AnGyeonheal/EV_Aerodynamic_Design/최종 보고서/2024_1_포스터_21900416_안견힐.pdf

# Optimal Design for Improving Drag and Cooling Performance of KSAE E-Mobility through CFD Analysis

G. H. An, C. S. LEE

Handong Global University Mechanical Control Engineering

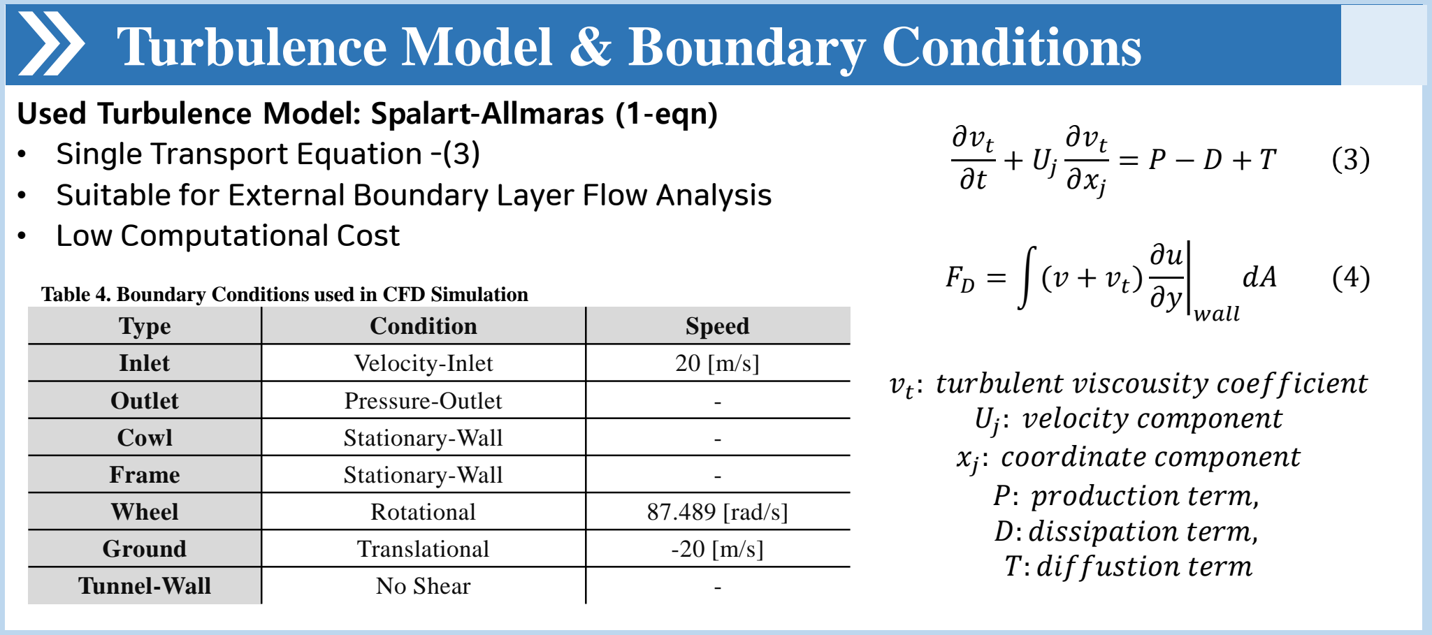
[picture p6: figure]
Turbulence Model & Boundary Conditions; Type; Condition; Speed; Inlet; Velocity-Inlet; Outlet; Pressure-Outlet; Cowl; Stationary-Wall; Frame; Wheel; Rotational; 87.489 [rad/s]; Ground; Translational; Tunnel-Wall; No Shear; Used Turbulence Model: Spalart-Allmaras (1-eqn) • Single Transport Equation -(3); • Low Computational Cost; wall; : turbulent viscousity coefficient Uj; : velocity component; : coordinate component P: production term, D: dissipation term, T: diffustion term

## Introduction

- This project aims to reduce drag and enhance the cooling efficiency of the electronic circuits in an electric vehicle designed for the KSAE (Korea Society of Automotive Engineers) university student competition through CFD (Computational Fluid Dynamics) analysis. The existing vehicle design has a structure that suffers from high drag and ineffective cooling of the electronic circuits. To address these issues, we utilized Ansys Fluent to propose a model that minimizes drag while improving the cooling of the electronic circuits. Additionally, we aim to verify the reliability of the CFD analysis results through wind tunnel experiments. The key factors determining the drag force(FD) of a vehicle are the projected area in the direction of fluid flow(A), the velocity of the fluid v

2
, and the drag coefficient (CD) due to the shape, as shown in Equation (1).
- Therefore, to minimize the flow separation phenomenon (Fig 1), which causes drag, the vehicle was designed with a streamlined shape to reduce the drag coefficient (CD) and to decrease the projected area (A), aiming to minimize the drag force.

## Model Description

- Advanced 1 (Frame Unmodified)
- Advanced 2 (Frame Modified)

Fig 3. NACA 4412 (α = −6°)(XFOIL)

Fig 4. NACA 2412 (α = −3°)(XFOIL)

Fig 5. NACA 4412 (α = −3°)(XFOIL)

- The model was inspired by the Power 0.5 model of Nose Cone Design (1), and the front part of the vehicle was designed with a streamlined shape.

y = R

x
L

2
1

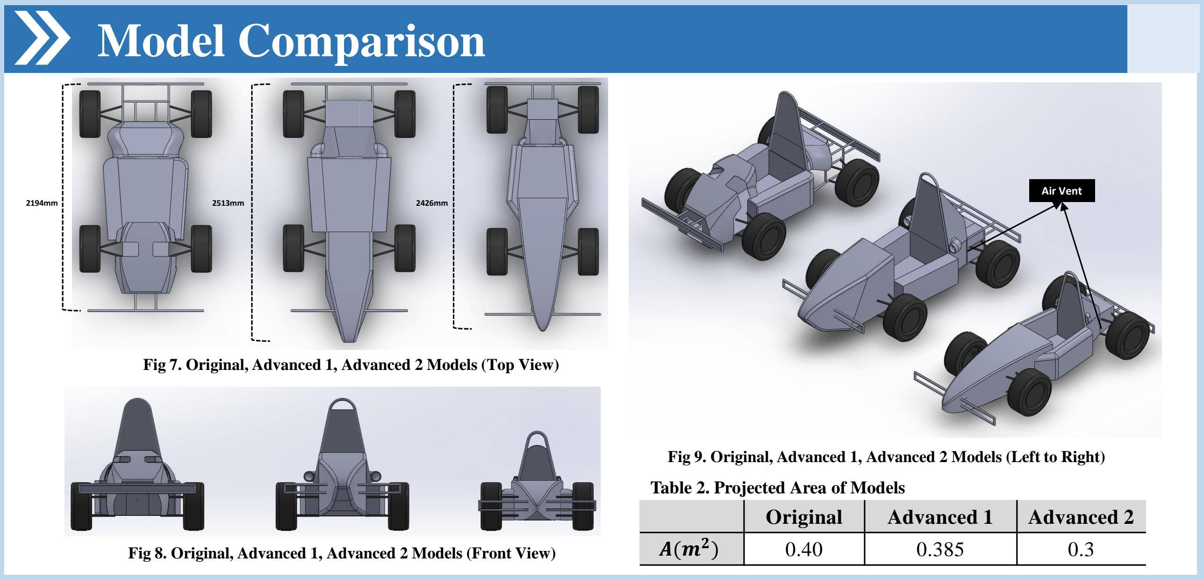
[picture p7: figure]
Fig 5. Original, Advanced 1, Advanced 2 Models (Up view); Model Comparison; Original; Advanced 1; Advanced 2; Air Vent; Table 2. Projected Area of Models

Fig 9. Original, Advanced 1, Advanced 2 Models (Left to Right)

Fig 6. Advanced 2 Model Sketch (NACA 2412)

RRH

NACA 2412

Driver

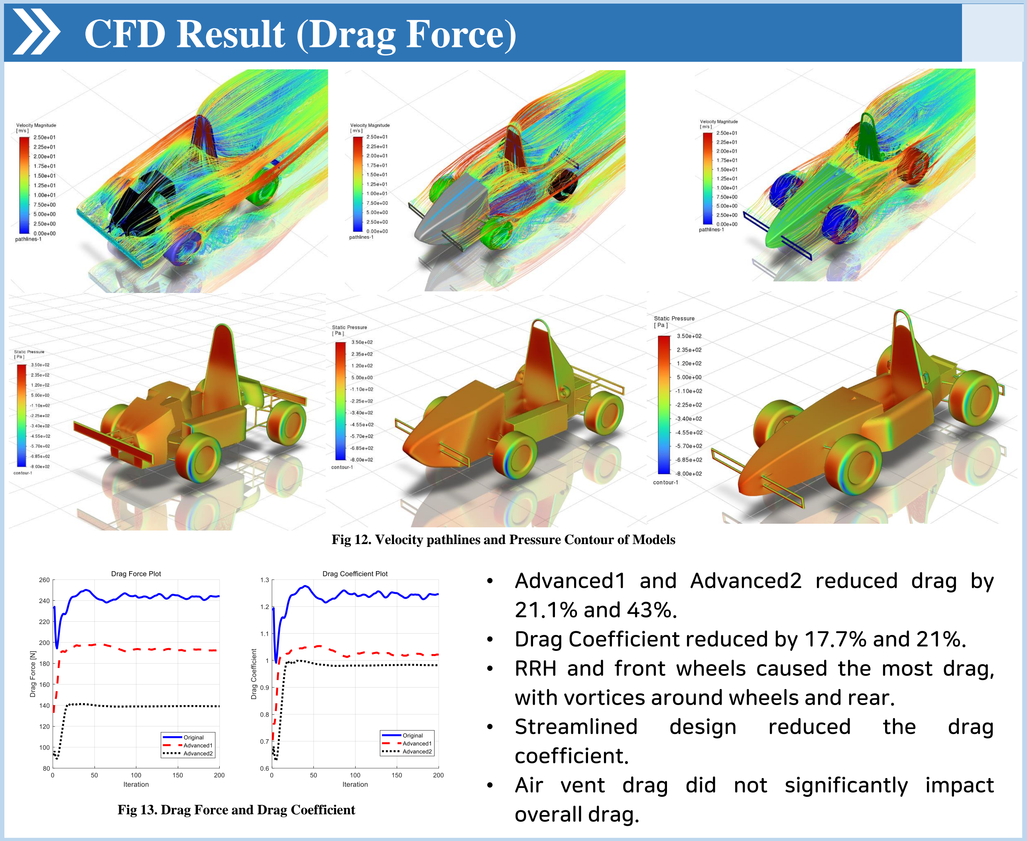
[picture p8: figure]
CFD Result (Drag Force); Fig 13. Drag Force and Drag Coefficient; 21.1% and 43%.; with vortices around wheels and rear.; • Streamlined; design; reduced; the; drag; coefficient.; overall drag.

## CFD Result (Cooling)

## Wind Tunnel Experiment Setting [Further Study]

z

## Discussion & Conclusion

- Suitable for External Boundary Layer Flow Analysis

Table 4. Boundary Conditions used in CFD Simulation

- The design is based on the NACA 2412 airfoil (at AOA, α = −3°), which has a low lift-to-drag ratio, and the smallest drag coefficient CD .
- The driver's seating position was changed from a sitting posture to a 30° reclining posture, reducing the height of the RRH by 350mm.

## Meshing Method

Region | Type | Size (mm)
BOI-nearfield | Body of Influence | 40
BOI-farfield | Body of Influence | 90
Bumper and Rods | Curvature | Min:4 / Max:5
Cowl | Curvature | Min:5 / Max:30
Wheel | Curvature | Min:3.5 / Max: 5
Boundary Layer | Last-ratio | 10 layers / Ratio: 0.2
Surface | Curvature & Proximity | Min: 0.5 / Max: 256
Volume | Poly-hexcore | Min: 0.5 / Max: 512

Table 3. Mesh Conditions

FD =

1
2

ρv

2CDA | 1

Fig 2. Power 0.5 Nose Cone Design

Fig 7. Original, Advanced 1, Advanced 2 Models (Top View)

Fig 8. Original, Advanced 1, Advanced 2 Models (Front View)

Fig 1. Separation Phenomenon

Table 1. Lift-to-Drag Ratio and Drag Coefficient of NACA Airfoil at Different Angles of Attack

Fig 11. Surface Mesh (Left), Volume Mesh (Right)

Fig 10. Mesh Convergence

Power [KW] | 8.6
Torque [Nm] | 33.9
ω [rad/s] | 254.59
Wheel Radius [m] | 0.115
ZA: ZB | 17:50
m [kg] | 250
fl
: friction loss | 0.7
cl
: circuit loss | 0.85

Ftℎrust =

T
R

×

ZB
ZA

× fl × cl = 515.87[N]

Table 5. DIY Car Spec Sheet

Fig 12. Velocity pathlines and Pressure Contour of Models

Fig 14. Rear Cowl Velocity Contour (Original, Advanced 1, Advanced 2)
- By adding an air vent shape, fast-flowing fluid through a narrow passage cools the electronic device with lower temperature fluid. (2.5m/s → 10m/s → 16m/s)

Amplifier

MCU

Rodcell

Honey Comb
Model
Electronic device | Electronic device | Electronic device
- Advanced1 and Advanced2 reduced drag by
- Drag Coefficient reduced by 17.7% and 21%.
- RRH and front wheels caused the most drag,
- Air vent drag did not significantly impact
- Uniform fluid flow is formed after passing through the honeycomb.
- The model's air resistance deforms the rod cell, changing its electrical resistance
- The amplified signal is sent to the MCU to calculate drag.
- The drag coefficient is calculated using the anemometer's fluid velocity and atmospheric conditions, and compared with simulation results

Fig 15. Wind Tunnel Experiment Settings

- The reduced drag (105[N]) is significant compared to the drive force (515.87[N]) from Table 4.
- Reduced drag can improve top speed and acceleration.
- Drag is proportional to the square of speed, so reducing the projected area and drag coefficient reduces drag.
- Safety device (RRH) regulations limited drag coefficient reduction (1.25 → 0.98).
- Adding air vents improved cooling and motor efficiency.
- Running time: 90min. Proper geometry and mesh generation are crucial (16-core process, 2.9 million cells).
