AnGyeonheal/EV_Aerodynamic_Design/최종 보고서/학술대회/생산제조학술대회_포스터_안견힐.pdf

# Optimal Design for Improving Drag and Cooling Performance of KSAE E-Mobility through CFD Analysis

G. H. An, C. S. LEE

Handong Global University Mechanical Control Engineering

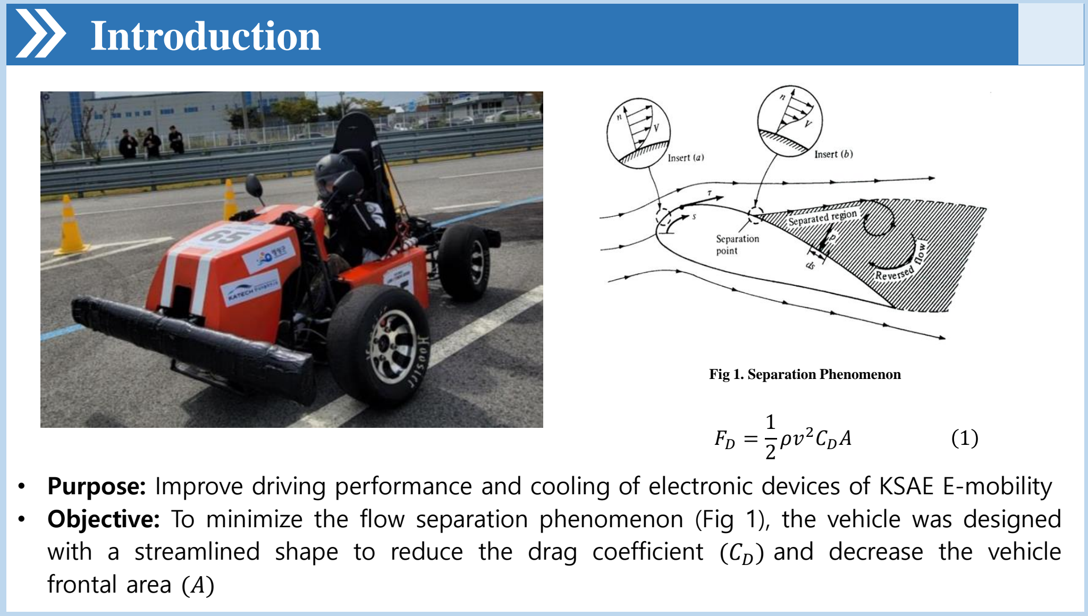
[picture p9: figure]
Introduction; frontal area (A); 2CDA; Fig 1. Separation Phenomenon

- Purpose: Improve driving performance and cooling of electronic devices of KSAE E-mobility
- Objective: To minimize the flow separation phenomenon (Fig 1), the vehicle was designed with a streamlined shape to reduce the drag coefficient (CD) and decrease the vehicle

## Model Description

- Advanced 1 (Frame Unmodified)
- Advanced 2 (Frame Modified)

Fig 3. NACA 4412 (α = −6°)(XFOIL)

Fig 4. NACA 2412 (α = −3°)(XFOIL)

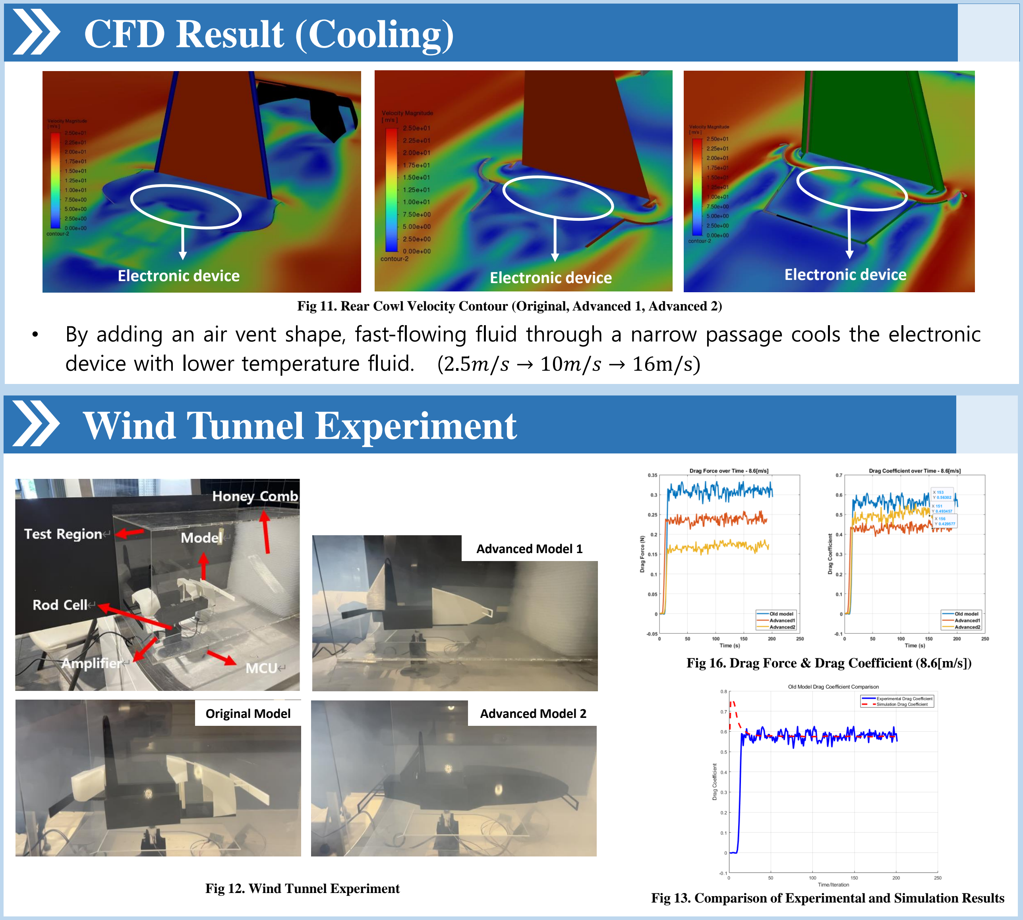
[picture p10: figure]
CFD Result (Cooling); Wind Tunnel Experiment; Electronic device; Fig 12. Wind Tunnel Experiment; Original Model; Advanced Model 1; Advanced Model 2

Fig 5. NACA 4412 (α = −3°)(XFOIL)

- The model was inspired by the Power 0.5 model of Nose Cone Design (1), and the front part of the vehicle was designed with a streamlined shape.

y = R

x
L

2
1

Fig 6. Advanced 2 Model Sketch (NACA 2412)

RRH

NACA 2412

Driver

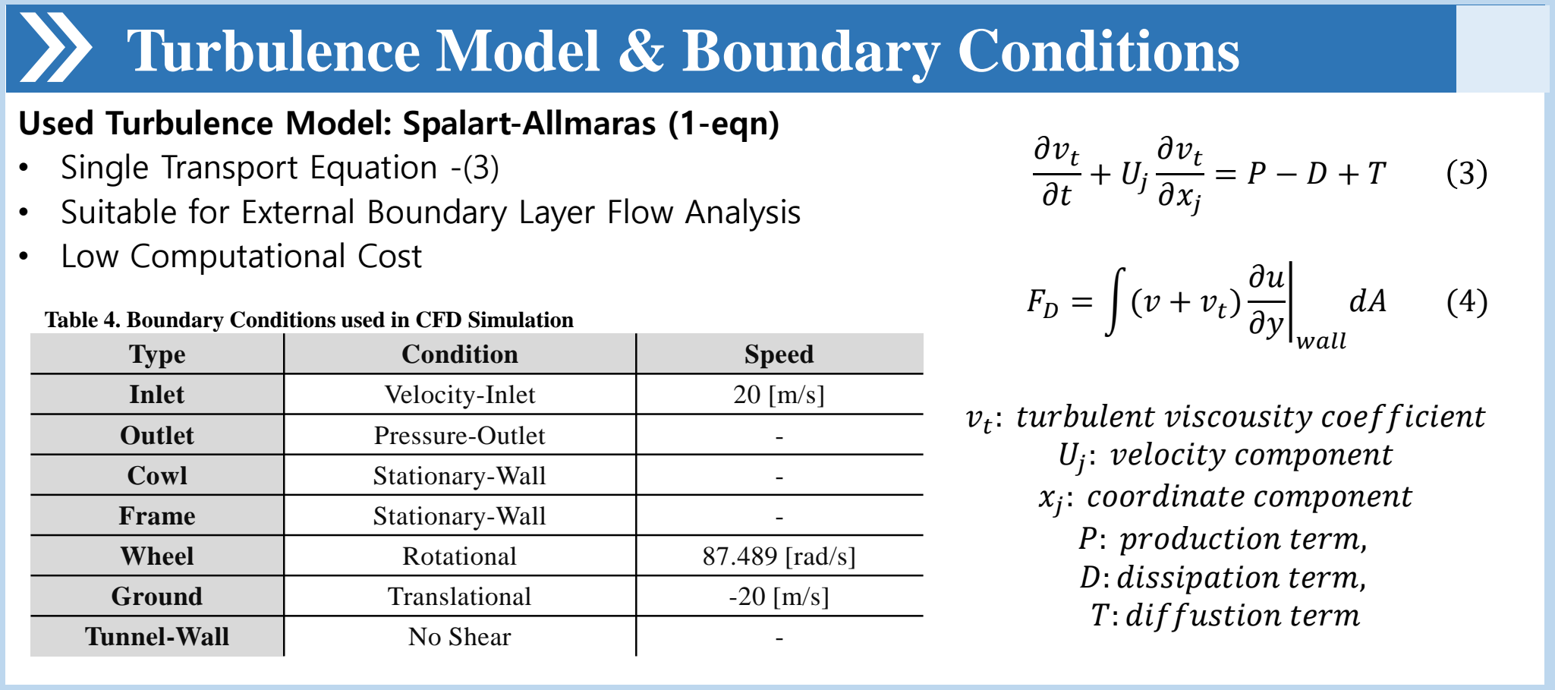
[picture p11: figure]
Turbulence Model & Boundary Conditions; Type; Condition; Speed; Inlet; Velocity-Inlet; Outlet; Pressure-Outlet; Cowl; Stationary-Wall; Frame; Wheel; Rotational; 87.489 [rad/s]; Ground; Translational; Tunnel-Wall; No Shear; Used Turbulence Model: Spalart-Allmaras (1-eqn) • Single Transport Equation -(3); • Low Computational Cost; wall; : turbulent viscousity coefficient Uj; : velocity component; : coordinate component P: production term, D: dissipation term, T: diffustion term

## CFD Result (Drag Force)

z

## Discussion & Conclusion

- Suitable for External Boundary Layer Flow Analysis

Table 4. Boundary Conditions used in CFD Simulation

- The design is based on the NACA 2412 airfoil (at AOA, α = −3°), which has a low lift-to-drag ratio, and the smallest drag coefficient CD .
- The driver's seating position was changed from a sitting posture to a 30° reclining posture, reducing the height of the RRH by 350mm.

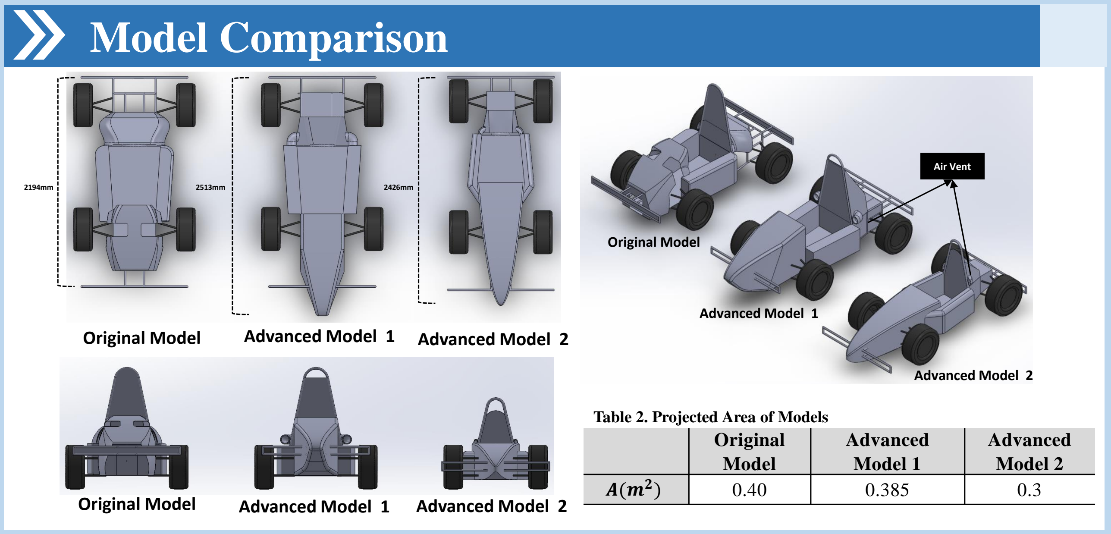
[picture p12: figure]
Fig 5. Original, Advanced 1, Advanced 2 Models (Up view); Model Comparison; Original Model; Advanced Model 1; Advanced Model 2; Air Vent; Table 2. Projected Area of Models

## Meshing Method

Region | Type | Size (mm)
BOI-nearfield | Body of Influence | 40
BOI-farfield | Body of Influence | 90
Bumper and Rods | Curvature | Min:4 / Max:5
Cowl | Curvature | Min:5 / Max:30
Wheel | Curvature | Min:3.5 / Max: 5
Boundary Layer | Last-ratio | 10 layers / Ratio: 0.2
Surface | Curvature & Proximity | Min: 0.5 / Max: 256
Volume | Poly-hexcore | Min: 0.5 / Max: 512

Table 3. Mesh Conditions

Fig 2. Power 0.5 Nose Cone Design

Table 1. Lift-to-Drag Ratio and Drag Coefficient of NACA Airfoil at Different Angles of Attack

Fig 8. Surface Mesh (Left), Volume Mesh (Right)

Fig 7. Mesh Convergence

Power [KW] | 8.6
Torque [Nm] | 33.9
ω [rad/s] | 254.59
Wheel Radius [m] | 0.115
ZA: ZB | 17:50
m [kg] | 250
fl
: friction loss | 0.7
cl
: circuit loss | 0.85

Ftℎrust =

T
R

×

ZB
ZA

× fl × cl = 515.87[N]

Table 5. DIY Car Spec Sheet

Fig 9. Velocity pathlines and Pressure Contour of Models

Fig 11. Rear Cowl Velocity Contour (Original, Advanced 1, Advanced 2)

Fig 10. Drag Force and Drag Coefficient

- By adding an air vent shape, fast-flowing fluid through a narrow passage cools the electronic device with lower temperature fluid. (2.5m/s → 10m/s → 16m/s)
- Drag force reduced by 21.1% for Advanced 1 model and by 43% for Advanced 2 model.
- Drag Coefficient reduced by 17.7% and 21%.
- RRH(Rear Roll Hoop) and front wheels caused the most drag, due to vortices in rear area.
- Streamlined design for advanced models reduced the drag coefficient.
- Reduced frontal area mostly contributed to reduction of drag force.
- Air vent drag did not significantly impact overall drag.
- The reduced drag (105[N]) is significant compared to the traction force of the vehicle (515.87[N]) in Table 5.
- Reducing the projected area and drag coefficient resulted in decreased drag force.
- Reduced drag can improve top speed and acceleration.
- Safety device (RRH) regulations limited drag force reduction up to 43%.
- Adding air vents improved cooling and motor efficiency.
- Simulation time: 90min. Proper geometry and mesh generation are crucial (16-core process, 2.9 million cells).

Fig 16. Drag Force & Drag Coefficient (8.6[m/s])

Fig 13. Comparison of Experimental and Simulation Results

Original Model Advanced Model 1 Advanced Model 2
