AnGyeonheal/EV_Aerodynamic_Design/풍동 실험/풍동 실험 이미지/21.jpg

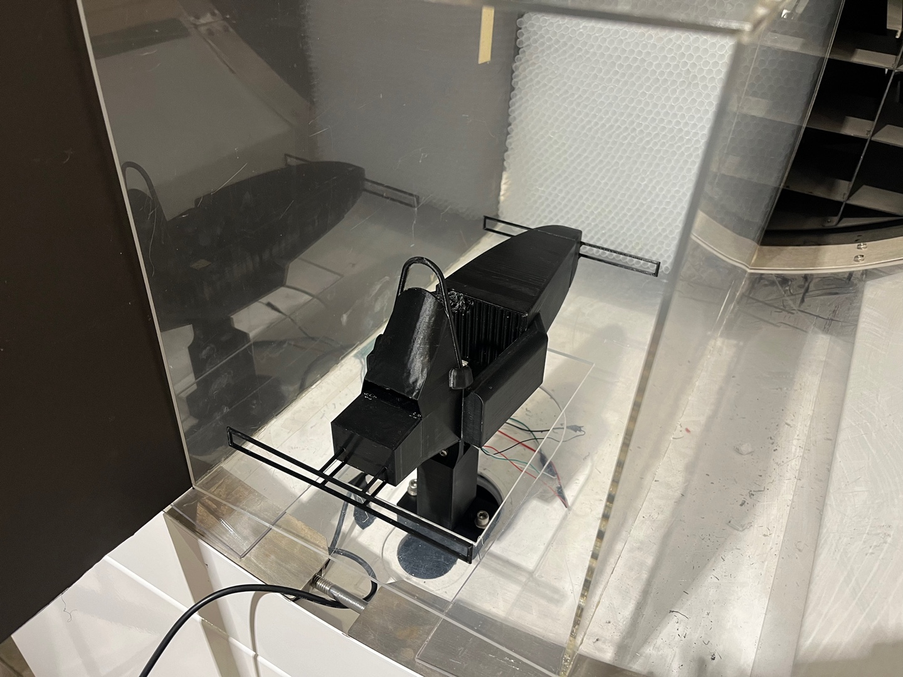
풍동 실험/풍동 실험 이미지/21.jpg
