AnGyeonheal/EV_Aerodynamic_Design/CAD/Car_Models/model_advanced_2/advanced_2.SLDASM

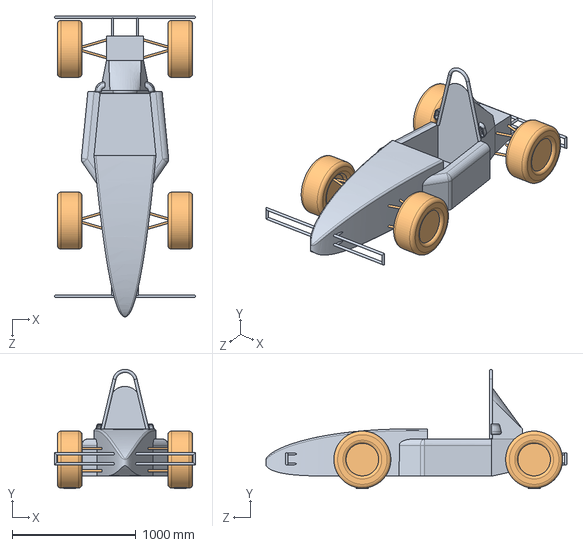
[picture p40: CAD file, 2025-01-29]
CAD/Car_Models/model_advanced_2/advanced_2.SLDASM
1140.0 x 962.4 x 2428.7 mm
advanced_2
wheel_arm_2 x 4
