AnGyeonheal/EV_Aerodynamic_Design/CAD/Car_Models/model_advanced_1/advanced_1.SLDASM

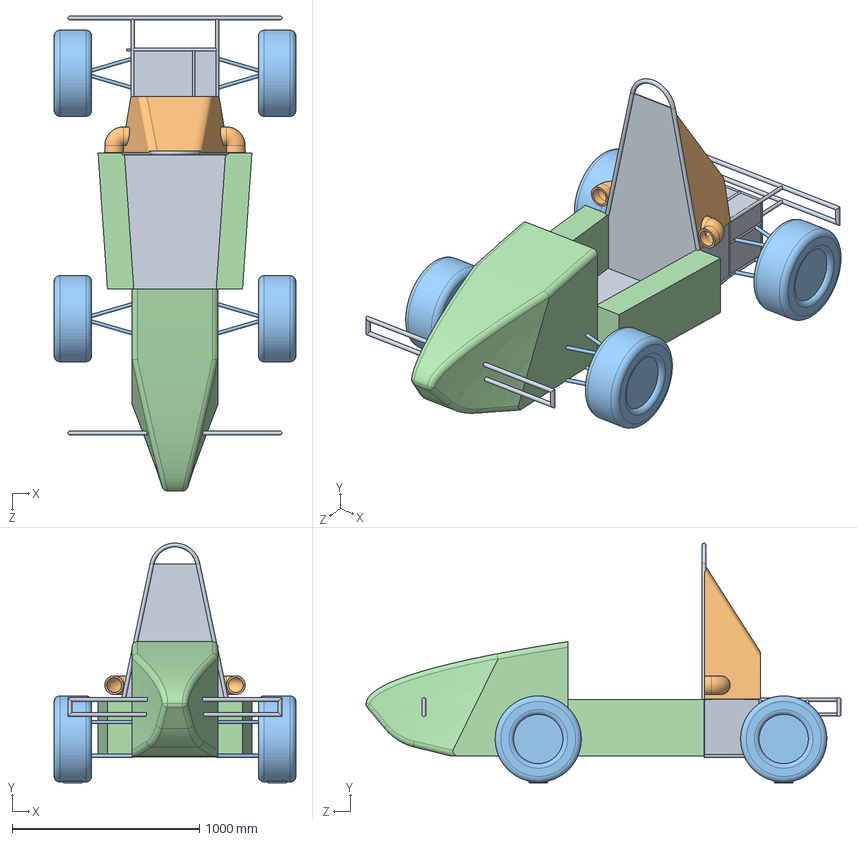
[picture p41: CAD file, 2025-01-29]
CAD/Car_Models/model_advanced_1/advanced_1.SLDASM
1290.0 x 1280.1 x 2535.0 mm
frame_simple_advanced_1
rear_cowl_advanced_1
wheel_arm_1 x 4
cowl_front_advanced_1
