AnGyeonheal/EV_Aerodynamic_Design/CAD/Car_Models/model_advanced_2/wheel_arm_2.SLDPRT

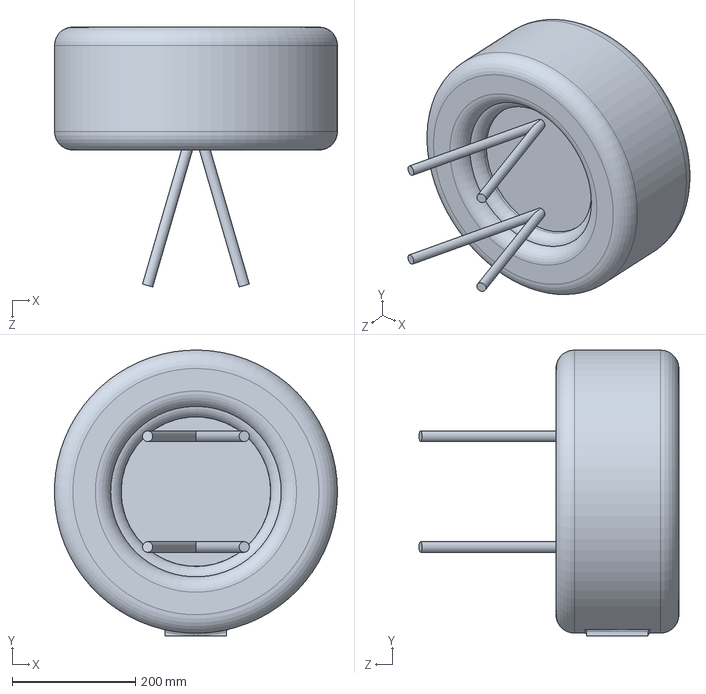
[picture p43: CAD file, 2025-01-29]
CAD/Car_Models/model_advanced_2/wheel_arm_2.SLDPRT
459.8 x 464.4 x 422.4 mm
