AnGyeonheal/EV_Aerodynamic_Design/CAD/Car_Models/model_advanced_1/rear_cowl_advanced_1.SLDPRT

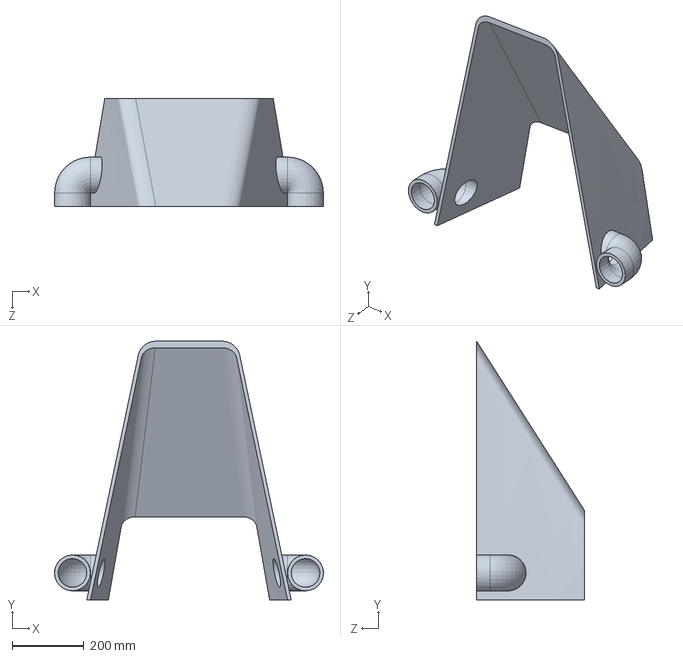
[picture p44: CAD file, 2025-01-29]
CAD/Car_Models/model_advanced_1/rear_cowl_advanced_1.SLDPRT
750.0 x 721.0 x 300.0 mm
