AnGyeonheal/EV_Aerodynamic_Design/CAD/Car_Models/model_advanced_1/frame_simple.SLDPRT

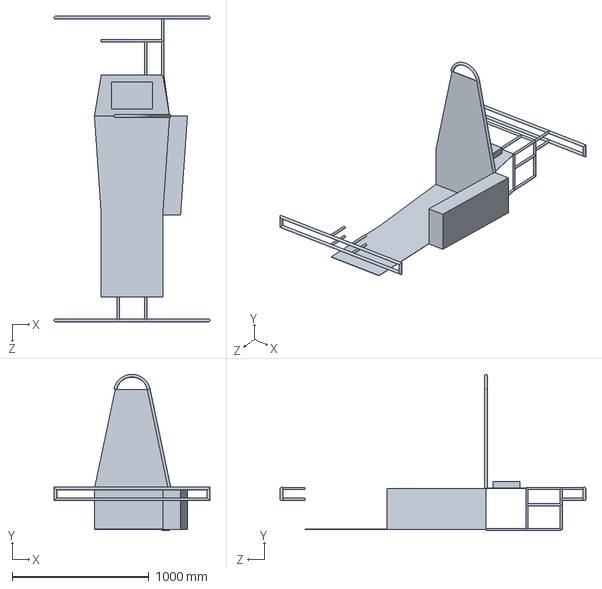
[picture p45: CAD file, 2025-01-29]
CAD/Car_Models/model_advanced_1/frame_simple.SLDPRT
1141.3 x 1144.2 x 2236.3 mm
