AnGyeonheal/EV_Aerodynamic_Design/CAD/Car_Models/model_advanced_1/cowl_front_advanced_1.SLDPRT

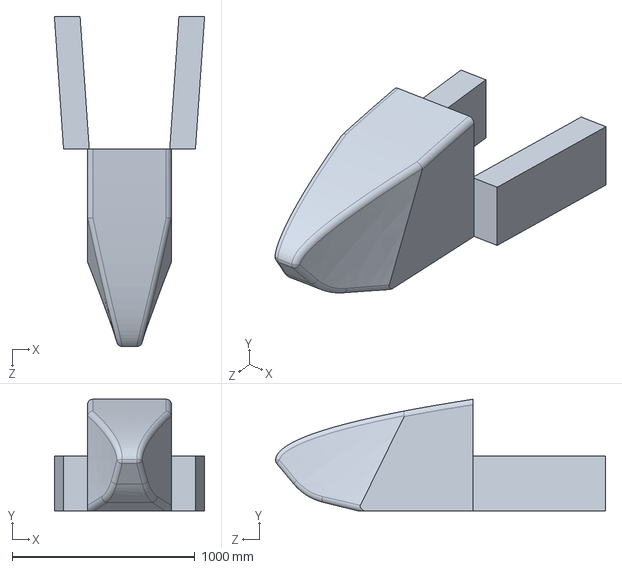
[picture p46: CAD file, 2025-01-29]
CAD/Car_Models/model_advanced_1/cowl_front_advanced_1.SLDPRT
821.4 x 610.0 x 1804.3 mm
