AnGyeonheal/EV_Aerodynamic_Design/CAD/Car_Models/model_old/original.SLDASM

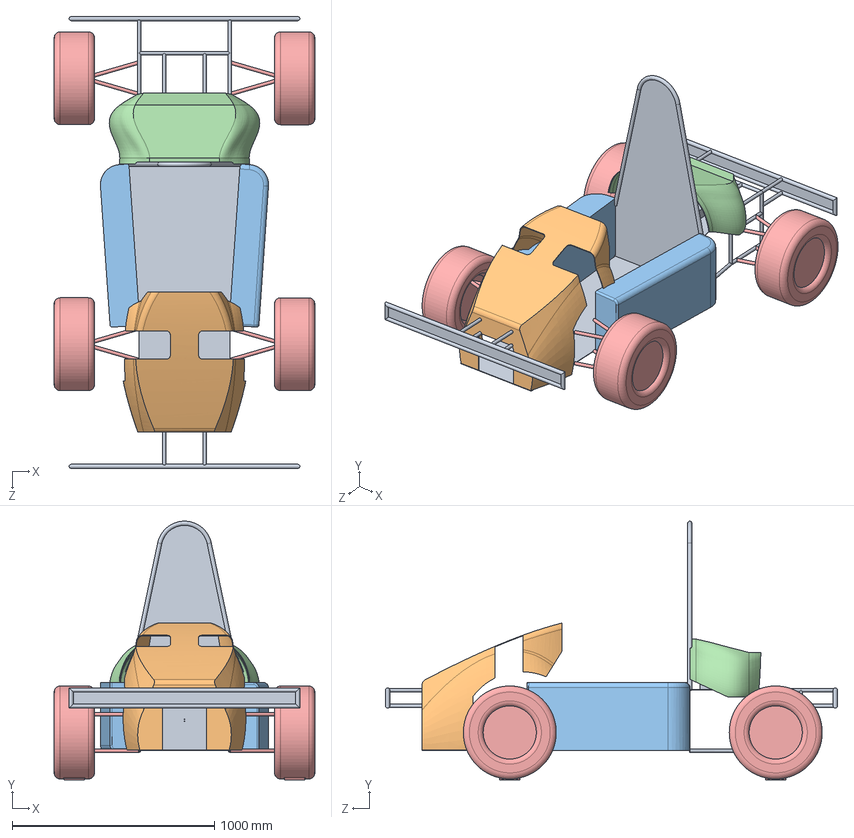
[picture p47: CAD file, 2025-01-29, an earlier design]
CAD/Car_Models/model_old/original.SLDASM
1290.0 x 1280.1 x 2236.3 mm
frame_simple_0
cowl_front
cowl_left x 2
cowl_RearPart
wheel_arm_0 x 4
