AnGyeonheal/EV_Aerodynamic_Design/CAD/Car_Models/model_old/frame_simple_0.SLDPRT

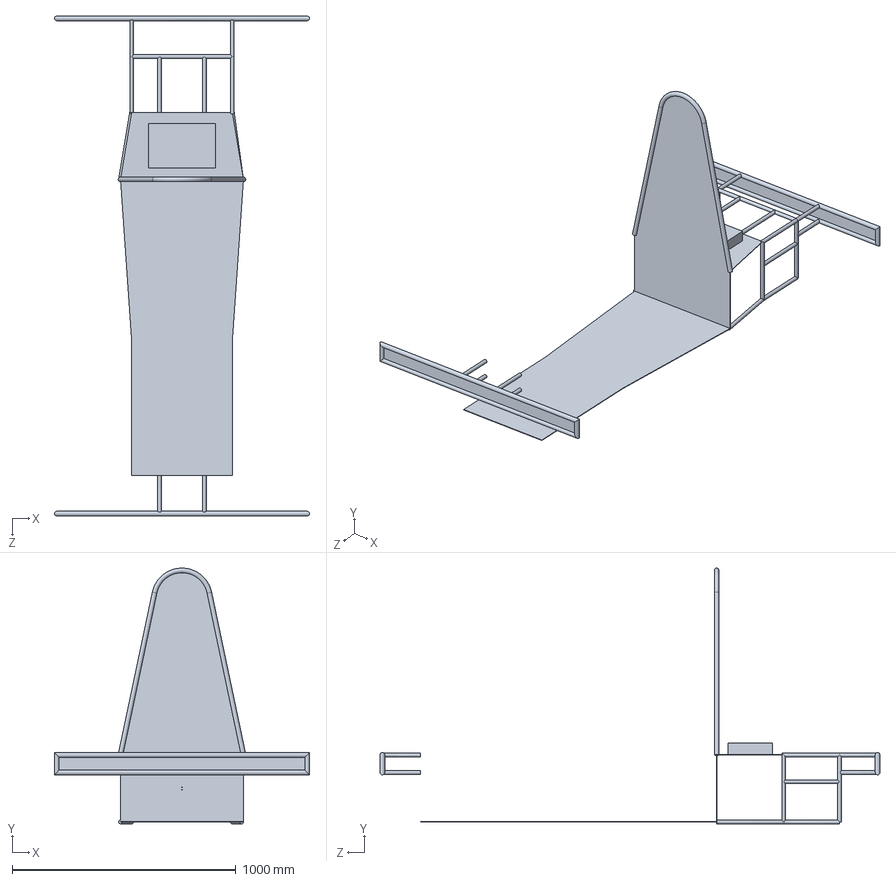
[picture p48: CAD file, 2025-01-29, an earlier design]
CAD/Car_Models/model_old/frame_simple_0.SLDPRT
1141.3 x 1144.2 x 2236.3 mm
