AnGyeonheal/EV_Aerodynamic_Design/CAD/Car_Models/model_old/cowl_RearPart.SLDPRT

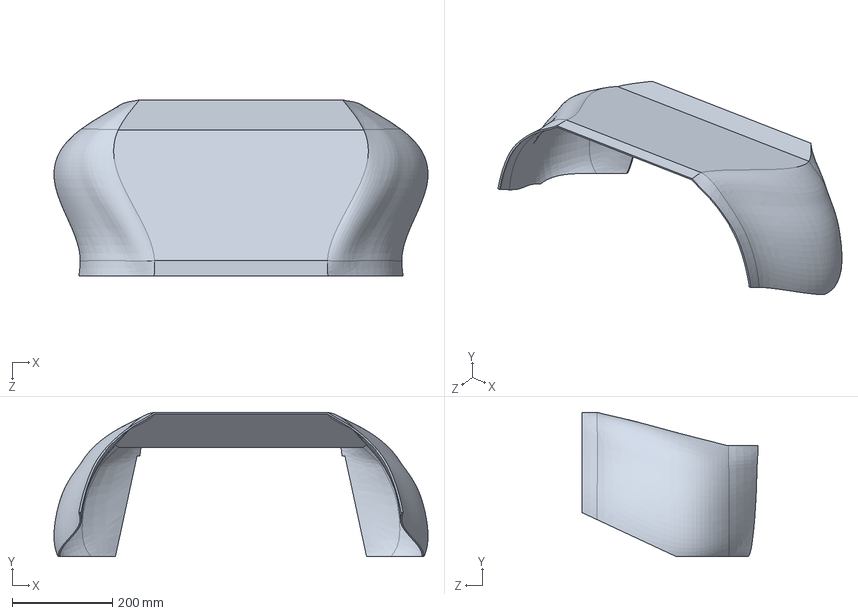
[picture p49: CAD file, 2025-01-29, an earlier design]
CAD/Car_Models/model_old/cowl_RearPart.SLDPRT
744.7 x 287.2 x 350.0 mm
