AnGyeonheal/EV_Aerodynamic_Design/CAD/Car_Models/model_old/cowl_left.SLDPRT

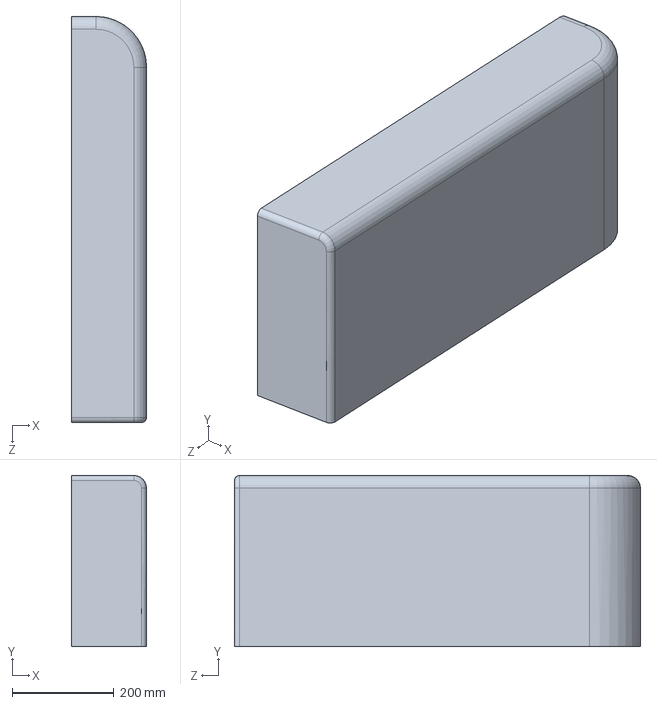
[picture p50: CAD file, 2025-01-29, an earlier design]
CAD/Car_Models/model_old/cowl_left.SLDPRT
148.0 x 337.0 x 800.0 mm
