AnGyeonheal/EV_Aerodynamic_Design/CAD/Car_Models/model_old/cowl_front.SLDPRT

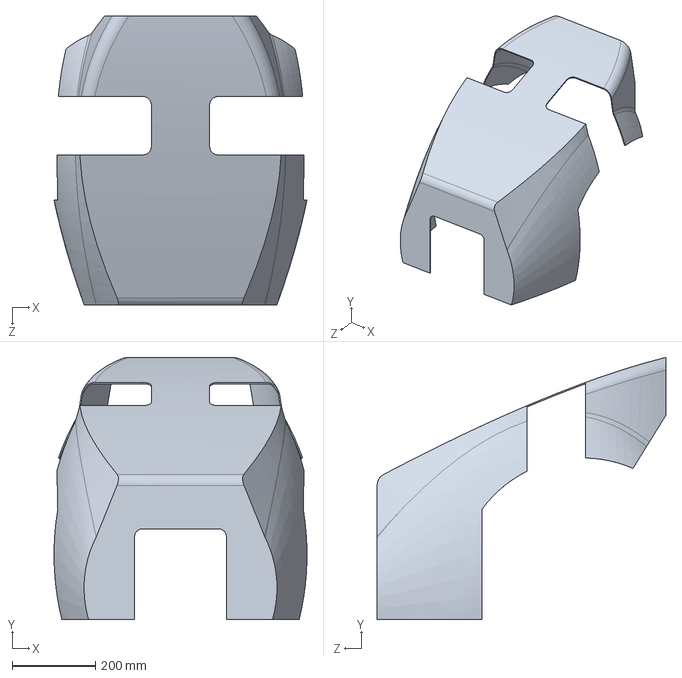
[picture p51: CAD file, 2025-01-29, an earlier design]
CAD/Car_Models/model_old/cowl_front.SLDPRT
607.2 x 629.1 x 693.0 mm
