AnGyeonheal/EV_Aerodynamic_Design/(list of files, cad)

Other CAD files:
CAD/Car_Models/model_advanced_2/advanced_2.SLDPRT
